techdude/takahashi-sky-patrol-ii-repair/photos/board_3d.png

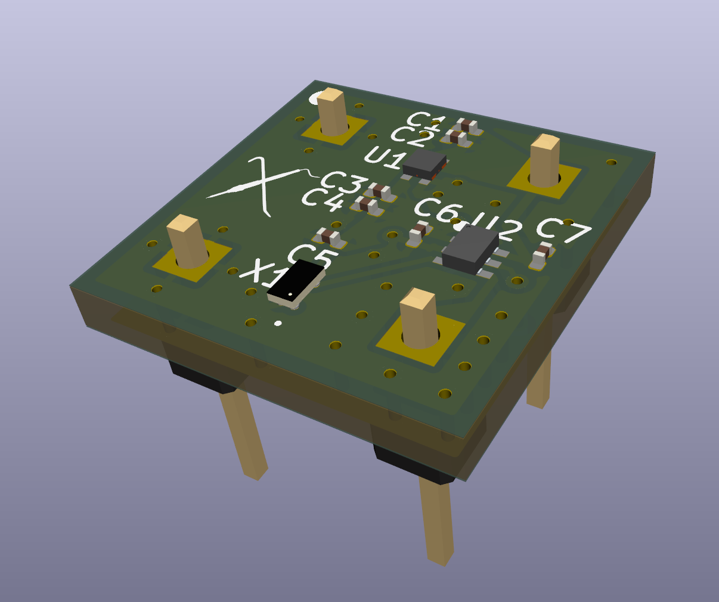
photos/board_3d.png
