techdude/takahashi-sky-patrol-ii-repair/photos/board_bottom.png

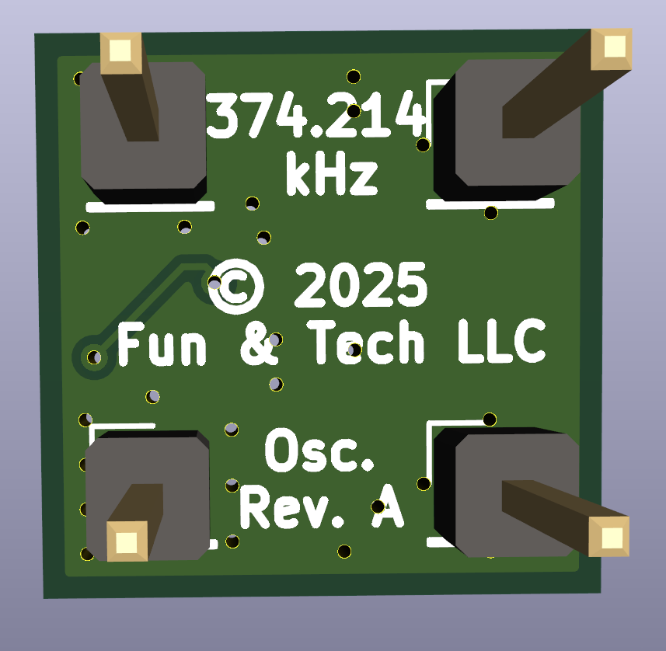
photos/board_bottom.png
