techdude/takahashi-sky-patrol-ii-repair/photos/board_side.png

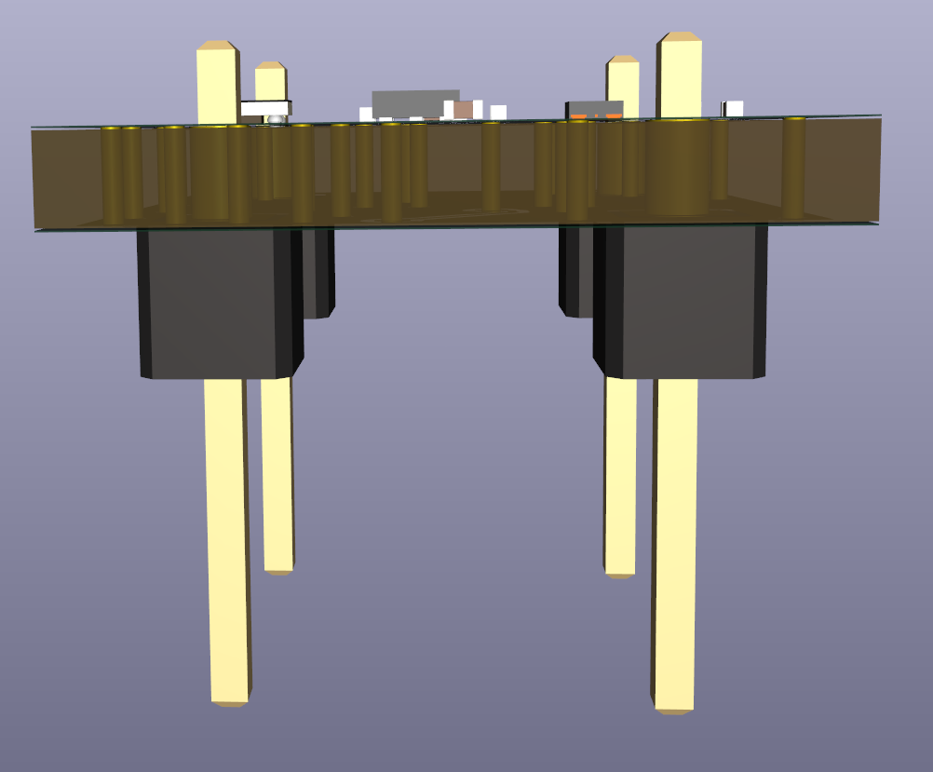
photos/board_side.png
