techdude/takahashi-sky-patrol-ii-repair/photos/board_top.png

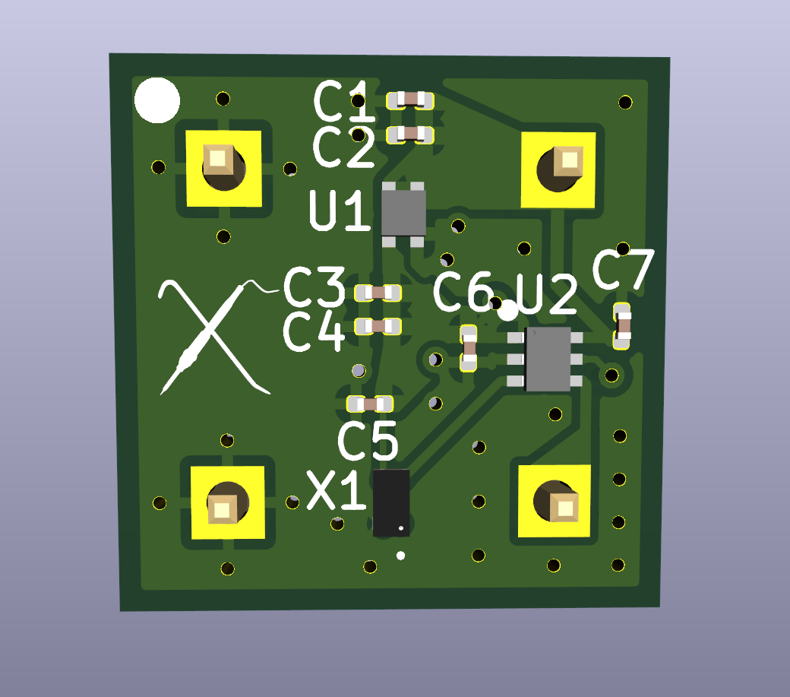
photos/board_top.png
