techdude/takahashi-sky-patrol-ii-repair/schematics/Oscillator Board Rev A.pdf

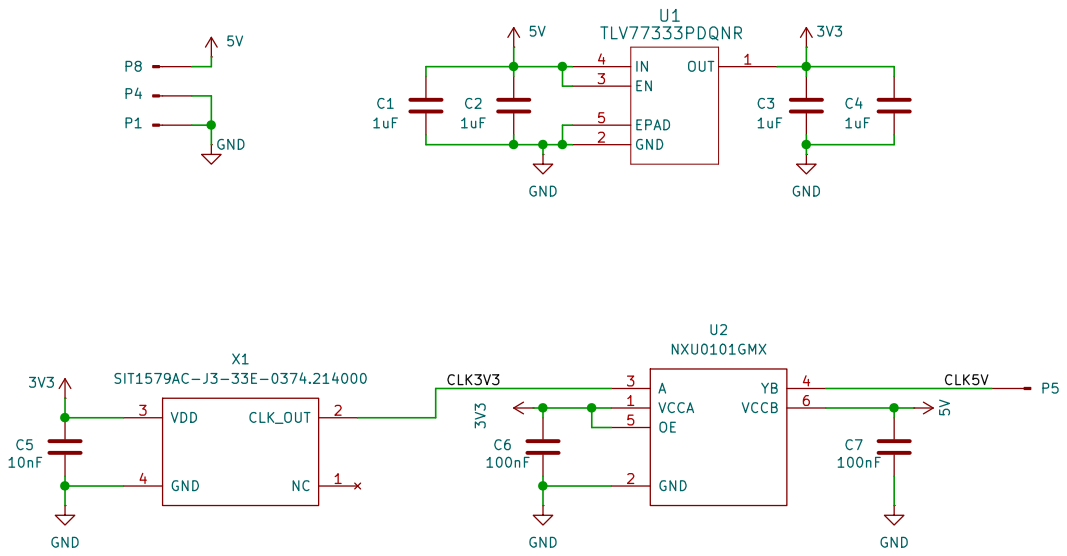
[picture p6: page 1]
