techdude/takahashi-sky-patrol-ii-repair/schematics/Takahashi Sky Patrol 2 Power Board Schematic Rev A.pdf

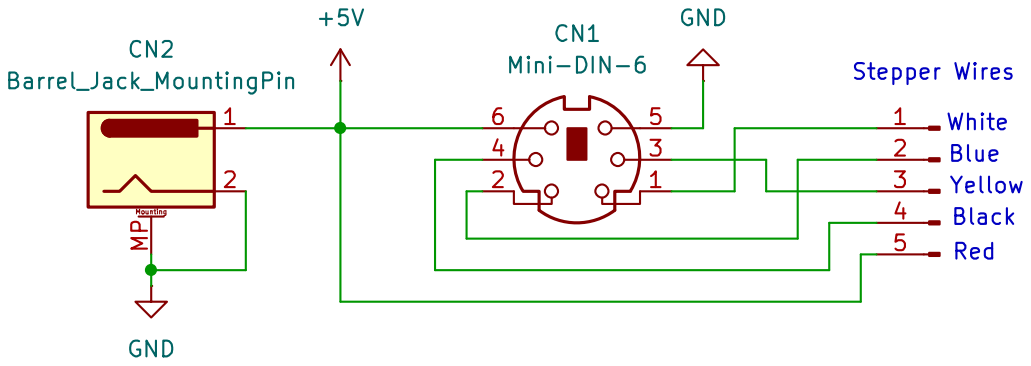
[picture p7: page 1]
