techdude/takahashi-sky-patrol-ii-repair/schematics/Takahashi Sky Patrol 2 Remote Board Schematic Rev B.pdf

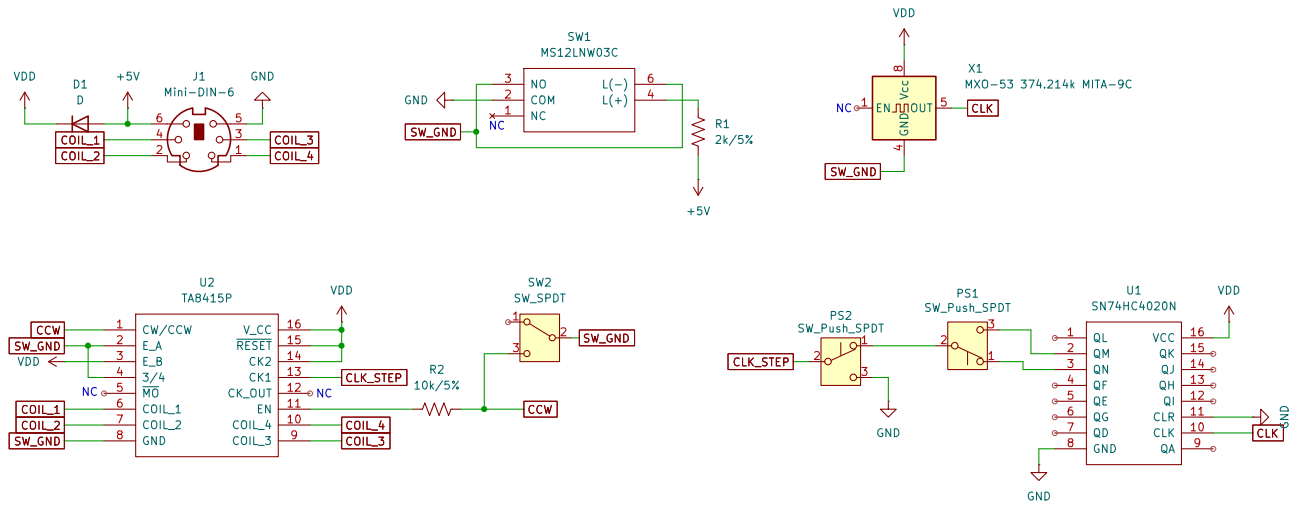
[picture p8: page 1]
