techdude/takahashi-sky-patrol-ii-repair/oscillator-board/Oscillator Board.kicad_pcb

## KiCad design oscillator-board/Oscillator Board.kicad_pcb (2025-06-21)

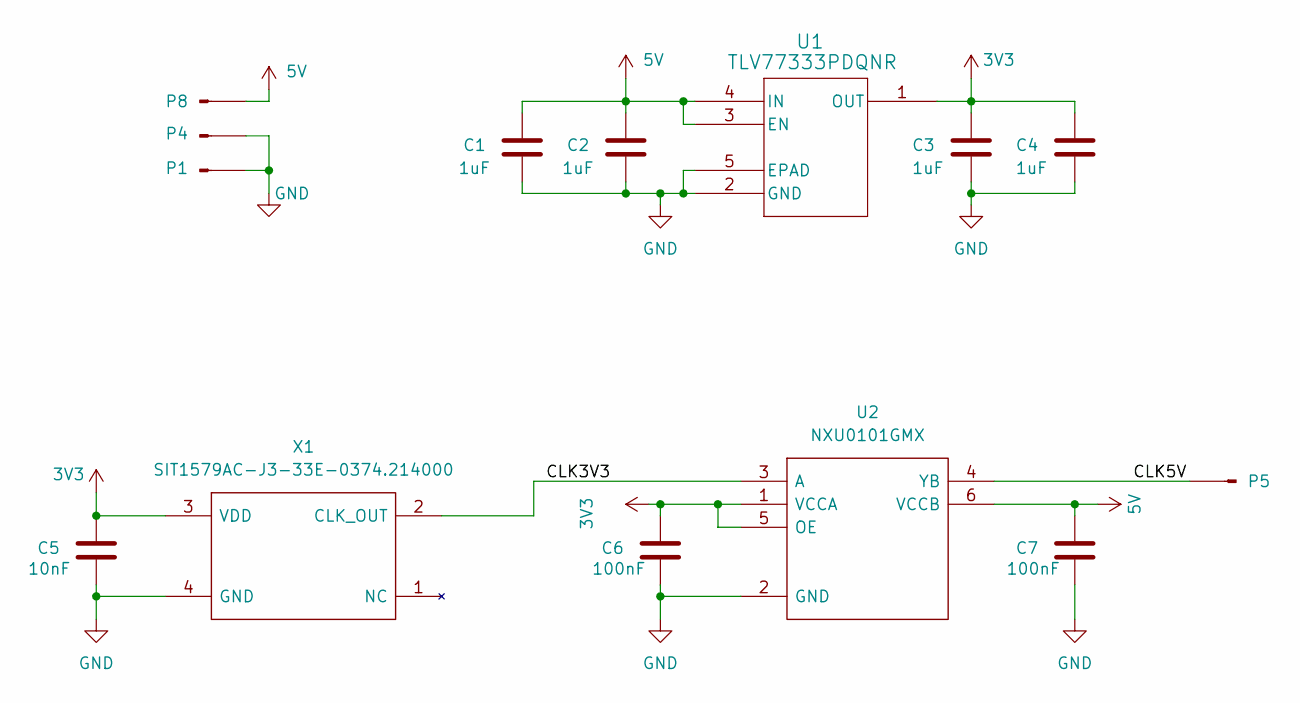
[picture p9: schematic Oscillator Board.kicad_sch, Replacement 5V 374.214kHz Oscillator]

Parts:
C1, C2, C3, C4: 1uF; C_0201_0603Metric
C5: 10nF; C_0201_0603Metric
C6, C7: 100nF; C_0201_0603Metric
P1, P4, P5, P8: Conn_01x01_Pin; PinHeader_1x01_P2.54mm_Vertical
U1: TLV77333PDQNR; X2SON_DQN4_TEX
U2: NXU0101GMX; SON50P100X145X50-6N; Manufacturer_Part_Number NXU0101GMX
X1: SIT1579AC-J3-33E-0374.214000; CSP_1508_4pins; Manufacturer_Part_Number SiT1579A-J3-0001

Connections:
3V3: C3.1, C4.1, C5.1, C6.1, U1.1 (OUT), U2.1 (VCCA), U2.5 (OE), X1.3 (VDD)
5V: C1.1, C2.1, C7.1, P8.1, U1.3 (EN), U1.4 (IN), U2.6 (VCCB)
/CLK3V3: U2.3 (A), X1.2 (CLK_OUT)
/CLK5V: P5.1, U2.4 (YB)
GND: C1.2, C2.2, C3.2, C4.2, C5.2, C6.2, C7.2, P1.1, P4.1, U1.2 (GND), U1.5 (EPAD), U2.2 (GND), X1.4 (GND)

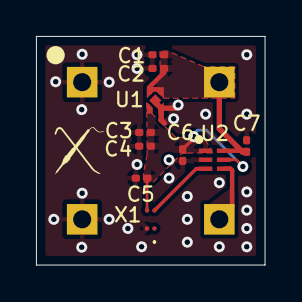
[picture p10: board Oscillator Board.kicad_pcb from above]

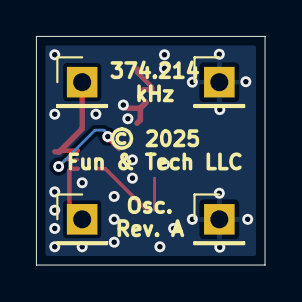
[picture p11: board Oscillator Board.kicad_pcb from below]

Board: 2 copper layers, 12.7 x 12.7 mm, 14 parts (4 on the bottom side), 5 nets.
