techdude/takahashi-sky-patrol-ii-repair/(notices)

Notices in the files:
oscillator-board/Oscillator Board.kicad_pcb:
© 2025
